vk4kyt/Forte-600-HF-RF-Amplifier/PDF/Forte_PA_Deck-B_Cu.pdf

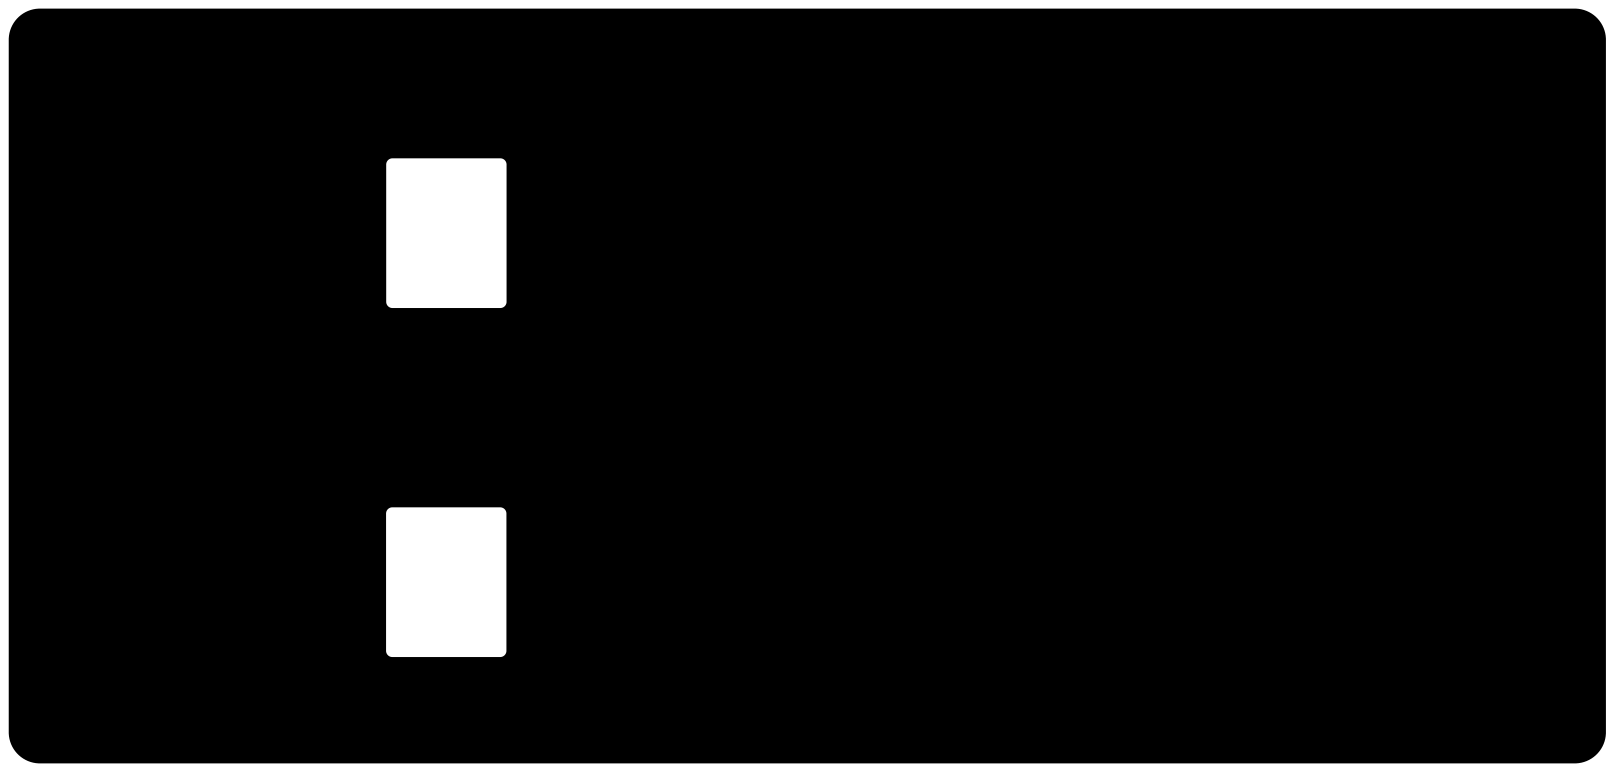
[picture p22: page 1]
