vk4kyt/Forte-600-HF-RF-Amplifier/PDF/Forte_PA_Deck-F_Cu.pdf

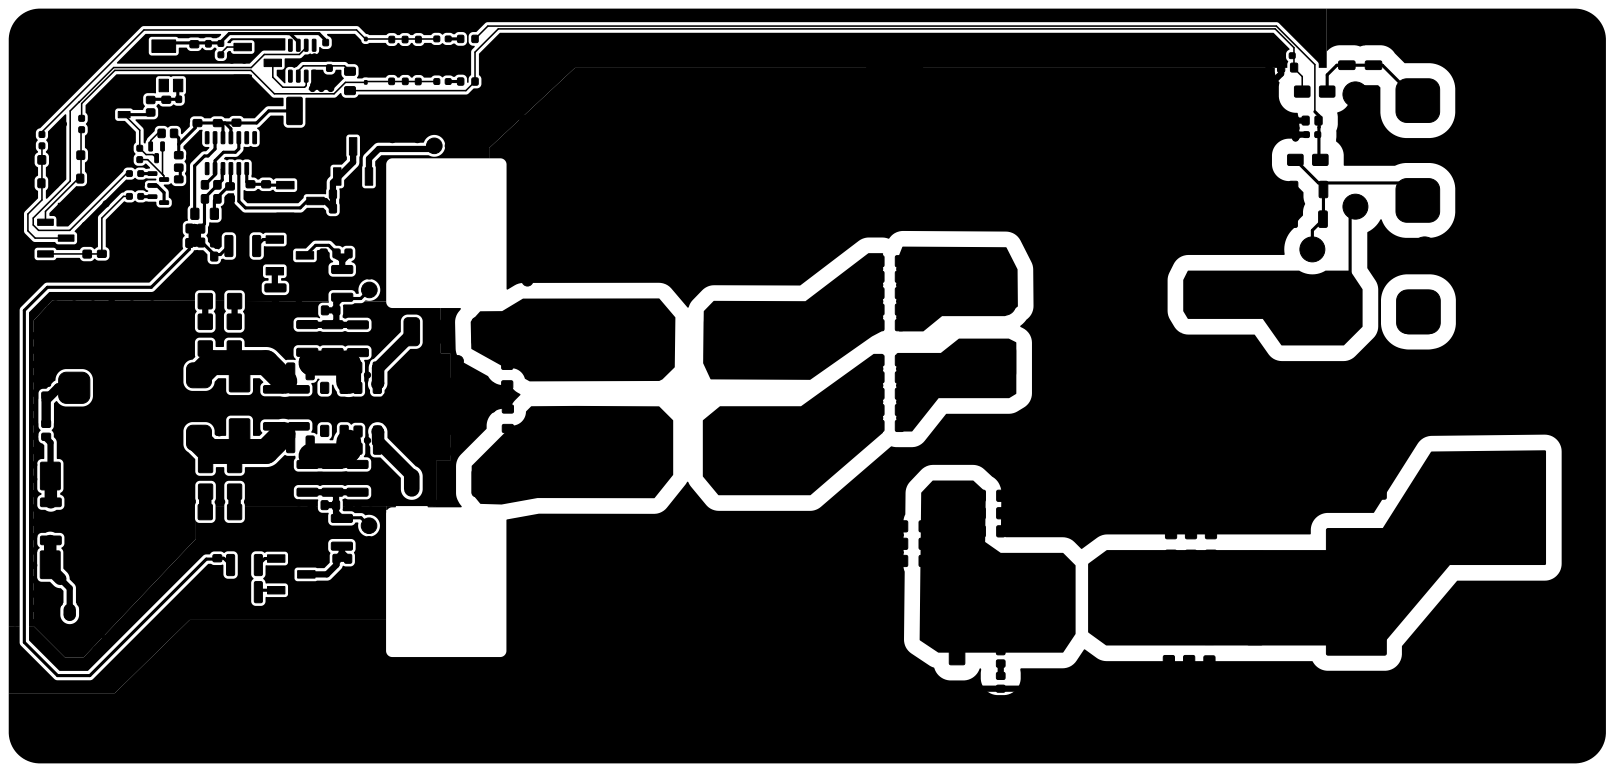
[picture p23: page 1]
