vk4kyt/Forte-600-HF-RF-Amplifier/PDF/Forte_PA_Deck-F_Silkscreen.pdf

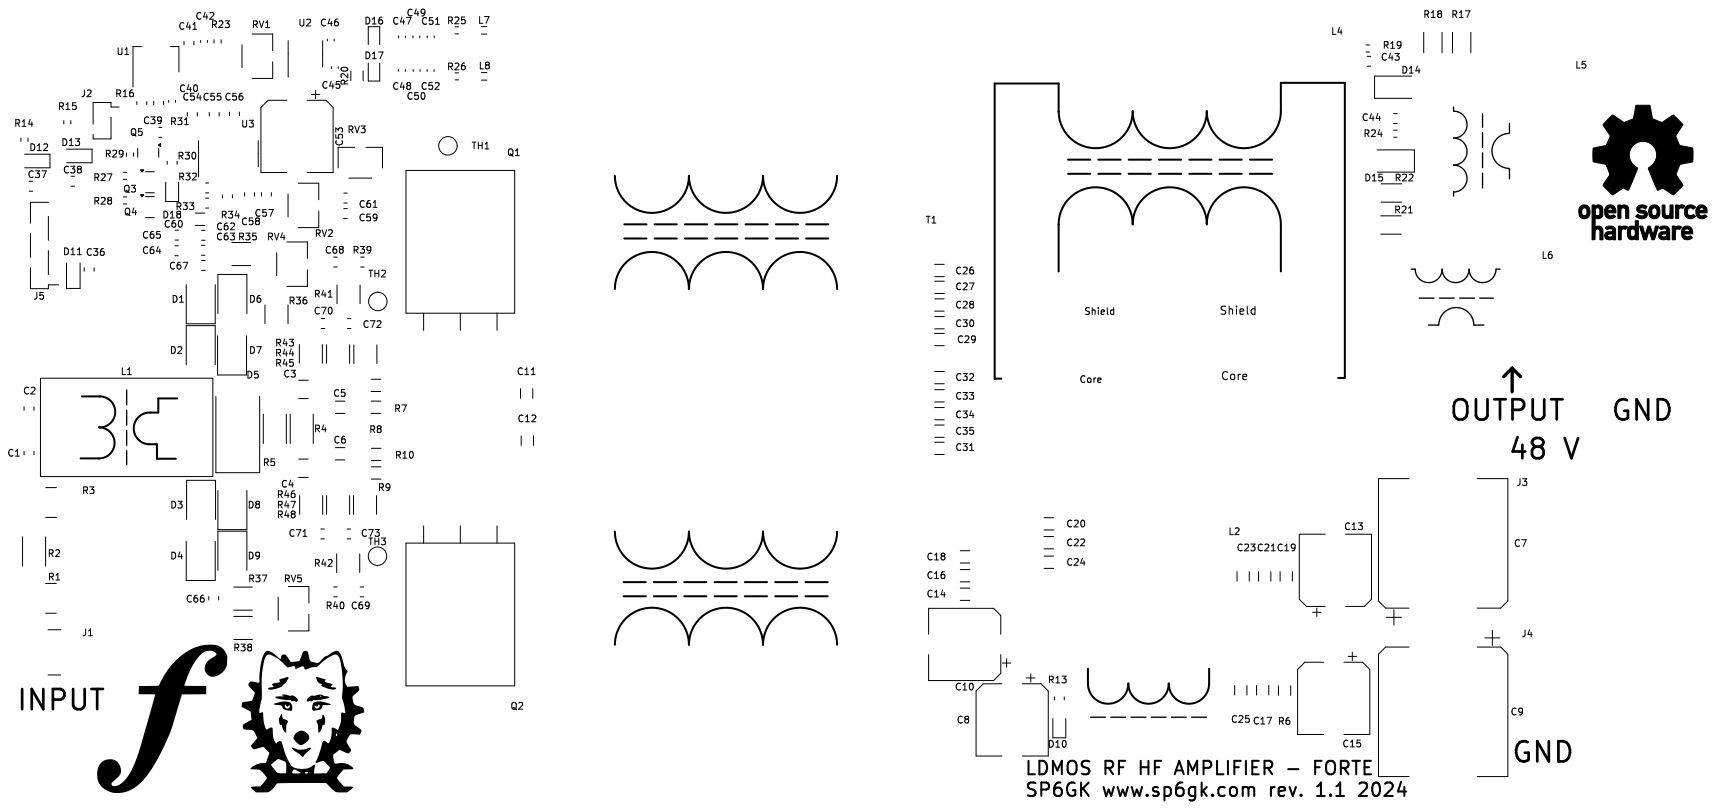
[picture p24: page 1]
