vk4kyt/Forte-600-HF-RF-Amplifier/Forte_PA_Deck.kicad_pcb

## KiCad design Forte_PA_Deck.kicad_pcb (2024-09-14)

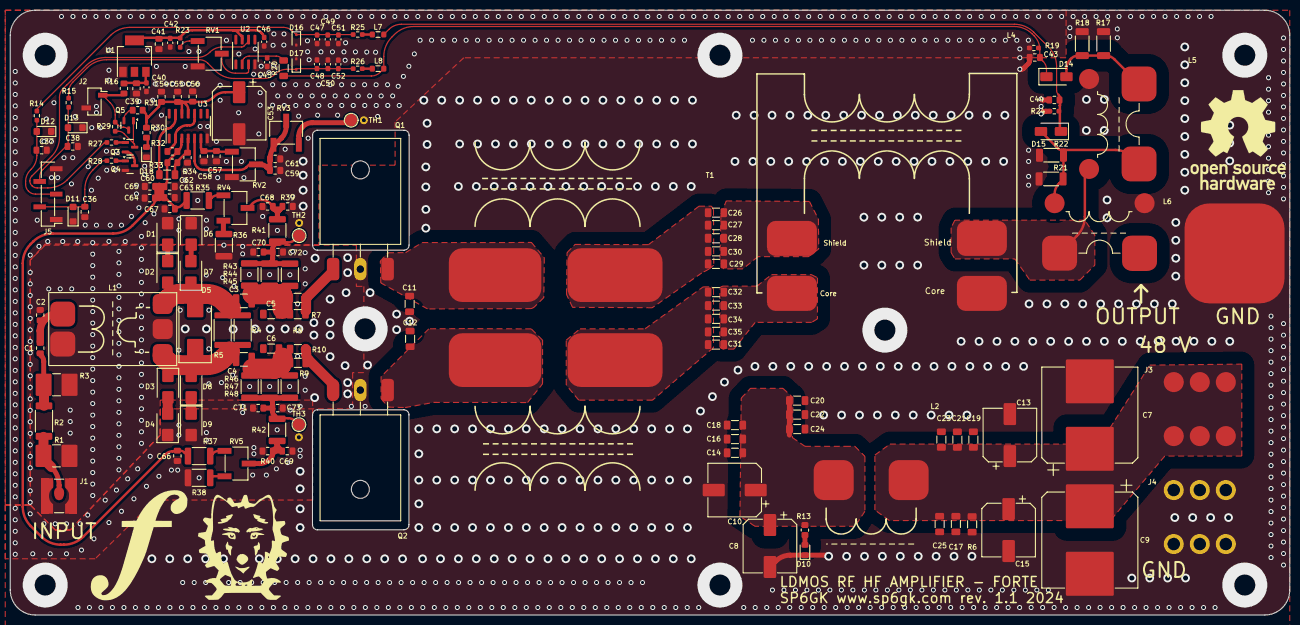
[picture p25: board Forte_PA_Deck.kicad_pcb from above]

Board: 2 copper layers, 256.0 x 121.0 mm, 167 parts (0 on the bottom side), 65 nets.

Parts:
C1: 33n; C_0805_2012Metric_Pad1.18x1.45mm_HandSolder
C2: 22p; C_0805_2012Metric_Pad1.18x1.45mm_HandSolder
C3, C4: 100n; C_1210_3225Metric_Pad1.33x2.70mm_HandSolder
C5, C6, C14, C16, C18, C19, C21, C29: 100n; C_1206_3216Metric_Pad1.33x1.80mm_HandSolder
C7, C9: 330u; CP_Elec_18x17.5
C8, C13: 33u; CP_Elec_10x10.5
C10, C15: 10u; CP_Elec_10x10.5
C11, C12, C60: 100p; C_1206_3216Metric_Pad1.33x1.80mm_HandSolder
C17: 1u; C_1206_3216Metric_Pad1.33x1.80mm_HandSolder
C20, C22, C23, C26, C27, C28, C30, C31, C32, C33, C34, C35: 22n; C_1206_3216Metric_Pad1.33x1.80mm_HandSolder
C24, C25: 10n; C_1206_3216Metric_Pad1.33x1.80mm_HandSolder
C36, C37, C38, C43, C44, C56, C58, C61, C65, C66, C67, C68, C69, C72, C73: 100n; C_0805_2012Metric_Pad1.18x1.45mm_HandSolder
C39, C41, C54, C57, C59, C62, C63: 10u; C_0805_2012Metric_Pad1.18x1.45mm_HandSolder
C40, C42, C45, C46, C49, C50: 100n; C_0603_1608Metric_Pad1.08x0.95mm_HandSolder
C47, C48: 1u; C_0603_1608Metric_Pad1.08x0.95mm_HandSolder
C51, C52: 10n; C_0603_1608Metric_Pad1.08x0.95mm_HandSolder
C53: 47u; CP_Elec_10x10.5
C55, C64, C70, C71: 1u; C_0805_2012Metric_Pad1.18x1.45mm_HandSolder
D1, D4, D6, D9: 1N4148WT; D_SMB
D2, D3, D7, D8: 4.7; D_SMB
D5: D_TVS; D_SMC_Handsoldering
D10: 48V_LED; LED_0805_2012Metric_Pad1.15x1.40mm_HandSolder
D11: 3.6; D_SMF
D12, D13: Protection TVS 5V; D_SMF
D14, D15: 1N4148W; D_SMA
D16, D17: SD12_SOD323; D_SOD-323
D18: BIAS_LED; LED_0805_2012Metric_Pad1.15x1.40mm_HandSolder
J1: SMA; SMA_Amphenol_132134-10_Vertical
J2: 5.08mm; PinSocket_1x02_P2.54mm_Vertical_SMD_Pin1Right
J3, J4: Keystone M5; M5_screw_terminal_Keystone
J5: Conn_01x05; PinHeader_1x05_P2.54mm_Vertical_SMD_Pin1Left
J6: Conn_Coaxial; Coax_connector
L1: 4:1; Binocular_trafo_small
L2: 12 uH 20 A; EMI_inductor
L4: 2x mat 43. 4T RG174 50 Ohm; Trafo_623-2661102002
L5: FT50-61 30T 1T RG-142 coax; FT82_trafo
L6: FT82-61 30T 1T-RG213 coax; FT82_trafo
L7, L8: 100u; L_0805_2012Metric_Pad1.05x1.20mm_HandSolder
Q1: MRF300AN; TO-247-3_Horizontal_TabDown
Q2: MRF300BN; TO-247-3_Horizontal_TabDown
Q3, Q4: BC846; SOT-23
Q5: AO3400A; SOT-23
R1, R3: 300; R_2816_7142Metric_Pad3.20x4.45mm_HandSolder
R2: 18; R_2512_6332Metric_Pad1.40x3.35mm_HandSolder
R4, R5: 33; R_2512_6332Metric
R6: 47k; C_1206_3216Metric_Pad1.33x1.80mm_HandSolder
R7, R8, R9, R10: 4.7; C_1206_3216Metric_Pad1.33x1.80mm_HandSolder
R13: x; R_0805_2012Metric_Pad1.20x1.40mm_HandSolder
R14, R15, R25, R26: 100; R_0603_1608Metric_Pad0.98x0.95mm_HandSolder
R16, R31, R32: 10; R_0805_2012Metric_Pad1.20x1.40mm_HandSolder
R17, R18, R21, R22: 100; R_2010_5025Metric_Pad1.40x2.65mm_HandSolder
R19, R24, R29: 10k; R_0603_1608Metric_Pad0.98x0.95mm_HandSolder
R20: 10k; R_1206_3216Metric_Pad1.30x1.75mm_HandSolder
R23, R27, R28: 1k; R_0603_1608Metric_Pad0.98x0.95mm_HandSolder
R30: 470; R_0805_2012Metric_Pad1.20x1.40mm_HandSolder
R33: 2.2k; R_0805_2012Metric_Pad1.20x1.40mm_HandSolder
R34: 14k; R_0805_2012Metric_Pad1.20x1.40mm_HandSolder
R35, R36, R37, R38, R41, R42, R43, R44, R45, R46, R47, R48: 100; R_1812_4532Metric_Pad1.30x3.40mm_HandSolder
R39, R40: 4.7k; C_0805_2012Metric_Pad1.18x1.45mm_HandSolder
RV1, RV2, RV3: 10k; Potentiometer_Bourns_3269W_Vertical
RV4, RV5: 500; Potentiometer_Bourns_3269W_Vertical
T1: Transformer_1P_1S; TLT_Trafo
TH1, TH2, TH3: 5k; R_Axial_DIN0207_L6.3mm_D2.5mm_P2.54mm_Vertical
U1: AMS1117-5.0; SOT-223-3_TabPin2
U2: OP07; SOIC-8_3.9x4.9mm_P1.27mm
U3: LM723_DIP14; SO-14_3.9x8.65mm_P1.27mm

Connections:
48V_IN: C7.1, C9.1, C13.1, C15.1, C17.1, C19.1, C21.1, C23.1, C25.1, J3.1, L2.1, R6.1
+5V: C41.1, C42.1, C46.1, R23.1, U1.2 (VO), U2.7 (V+)
+12V: J2.1, Q5.3 (D), R16.1, R29.1
+48V: C8.1, C10.1, C14.1, C16.1, C18.1, C20.1, C22.1, C24.1, L2.2, R13.1
/AMOS_D: C11.2, Q1.3 (D), T1.1 (AA)
/ATLT_OUT: C26.1, C27.1, C28.1, C29.1, C30.1, T1.2
/BMOS_D: C12.1, Q2.1 (D), T1.3
/BTLT_OUT: C31.1, C32.1, C33.1, C34.1, C35.1, T1.4
/Bias_regulation/A_MOS_G: C3.2, C5.1, R7.1, R8.1, R43.2, R44.2, R45.2
/Bias_regulation/B_MOS_G: C4.2, C6.1, R9.1, R10.1, R46.2, R47.2, R48.2
/Bias_regulation/Bias_DC_IN: C53.1, C54.1, C55.1, C56.1, R30.1, R31.2, U3.11 (VC), U3.12 (V+)
/Bias_regulation/Bias_EN: C36.1, D11.2 (A2), J5.2, R28.1
/Bias_regulation/Bias_Voltage: C62.1, C63.1, C64.1, C65.1, C66.1, C67.1, R32.2, R33.1, R35.1, R37.1, U3.3 (CSEN)
/Bias_regulation/~HIGH_SWR: R27.1, U2.6
/SWR_Meter/FWD_PWR: C47.1, C49.1, C51.1, D16.1 (A1), R14.1, R25.1
/SWR_Meter/IN: L4.1, L5.4, L6.1
/SWR_Meter/OUT: J6.1 (In), L6.2
/SWR_Meter/REF_PWR: C48.1, C50.1, C52.1, D17.1 (A1), R15.1, R26.1
/To_GateA: C3.1, D2.2 (A), D5.2 (A2), D7.1 (K), L1.3, R4.1, R5.1
/To_GateB: C4.1, D3.1 (K), D5.1 (A1), D8.2 (A), L1.4, R4.2, R5.2
GND: C2.1, C7.2, C8.2, C9.2, C10.2, C11.1, C12.2, C13.2, C14.2, C15.2, C16.2, C17.2, C18.2, C19.2, C20.2, C21.2, C22.2, C23.2, C24.2, C25.2, C36.2, C37.2, C38.2, C39.2, C40.2, C41.2, C42.2, C43.2, C44.2, C45.2, C46.2, C47.2, C48.2, C49.2, C50.2, C51.2, C52.2, C53.2, C54.2, C55.2, C56.2, C57.2, C58.2, C59.2, C61.2, C62.2, C63.2, C64.2, C65.2, C66.2, C67.2, C68.2, C69.2, C70.2, C71.2, C72.2, C73.2, D1.2 (A), D4.1 (K), D6.1 (K), D9.2 (A), D10.1 (K), D11.1 (A1), D12.1 (A1), D13.1 (A1), D16.2 (A2), D17.2 (A2), D18.1 (K), J1.2 (Ext), J2.2, J4.1, J5.1, J5.5, J6.2 (Ext), L1.1, L4.3, L5.3, L6.3, Q1.2 (S), Q2.2 (S), Q4.2 (E), R1.2, R3.2, R6.2, R17.1, R18.1, R19.2, R21.2, R22.2, R24.2, R34.2, R36.2, R38.2, R39.2, R40.2, RV1.3, RV2.3, TH1.2, TH2.2, TH3.2, U1.1 (GND), U2.4 (V-), U3.7 (V-)
unnamed: C1.1, R2.2, R3.1
unnamed: C1.2, C2.2, L1.2
unnamed: C26.2, C27.2, C28.2, C29.2, C30.2, L4.2
unnamed: C31.2, C32.2, C33.2, C34.2, C35.2, L4.4
unnamed: C68.1, R39.1, R41.1, RV4.2
unnamed: C69.1, R40.1, R42.1, RV5.2
unnamed: C70.1, C72.1, R41.2, R43.1, R44.1, R45.1, TH2.1
unnamed: C71.1, C73.1, R42.2, R46.1, R47.1, R48.1, TH3.1
unnamed: D1.1 (K), D2.1 (K)
unnamed: D3.2 (A), D4.2 (A)
unnamed: D6.2 (A), D7.2 (A)
unnamed: D8.1 (K), D9.1 (K)
unnamed: D10.2 (A), R13.2
unnamed: C37.1, D12.2 (A2), J5.3, R14.2
unnamed: C38.1, D13.2 (A2), J5.4, R15.2
unnamed: D14.2 (A), L5.2, R17.2, R18.2
unnamed: C43.1, D14.1 (K), L8.1, R19.1, R20.1
unnamed: D15.2 (A), L5.1, L6.4, R21.1, R22.1
unnamed: C44.1, D15.1 (K), L7.1, R24.1
unnamed: D18.2 (A), R30.2
unnamed: J1.1 (In), R1.1, R2.1
unnamed: L7.2, R25.2
unnamed: L8.2, R26.2
unnamed: Q1.1 (G), R7.2, R8.2
unnamed: Q2.3 (G), R9.2, R10.2
unnamed: Q3.1 (B), R27.2
unnamed: Q3.3 (C), Q5.1 (G), R29.2
unnamed: Q3.2 (E), Q4.3 (C)
unnamed: Q4.1 (B), R28.2
unnamed: Q5.2 (S), R31.1
unnamed: R23.2, RV1.1
unnamed: R35.2, RV4.1
unnamed: R36.1, RV4.3
unnamed: R37.2, RV5.1
unnamed: R38.1, RV5.3
unnamed: RV3.3, TH1.1
unnamed: C39.1, C40.1, R16.2, U1.3 (VI)
unnamed: RV1.2, U2.3 (+)
unnamed: C45.1, R20.2, U2.2 (-)
unnamed: C59.1, C61.1, RV2.2, RV3.1, RV3.2, U3.5 (+)
unnamed: C60.2, R33.2, R34.1, U3.4 (-)
unnamed: C60.1, U3.13 (FC)
unnamed: R32.1, U3.2 (ILIM), U3.10 (Vout)
unnamed: C57.1, C58.1, RV2.1, U3.6 (VREF)
