vk4kyt/Forte-600-HF-RF-Amplifier/(commit log)

2024-09-01 Add files via upload
    Fixed DRC shorted nets error
    [Bias_circuit.kicad_sch, Forte_PA_Deck.kicad_pcb, Forte_PA_Deck.kicad_sch, swr_meter_protection.kicad_sch]
2024-09-10 Used ERC on PA-Deck Schematic
    Initially many hundreds of warnings, and some errors.
    Apart from 8 exclusions These have all largely been fixed.
    Many Symbols required updating from the appropriate library, but mostly a huge number or warnings about "symbol pin or wire end off grid connection". Took a while, but I figured out what the problem is.
    L5 & L6 exclusion referred to a TXRX library that wasn't available.
    [Bias_circuit.kicad_sch, Forte_PA_Deck.kicad_sch, swr_meter_protection.kicad_sch]
2024-09-14 Ready to Order
    Applied minor changes in preparation to order CPBs and components.
    [Bias_circuit.kicad_sch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]
